amigageek/susy/sim/test_attenuator.asc

M1: pmos; AO6407
R1: res; 4.7K
R2: res; 100K
R3: res; 100K
V1: voltage; 3.3
V2: voltage; SINE(2.2 50m 2k)
V3: voltage; PULSE(0 3.3 0 10m 10m 0m 20m)
V4: voltage; 0
V6: voltage; 2.2
X1: attenuator
Named nets: 0, VCC, SIGNAL, GAIN, VGND, GATE
.global VCC VGND
.MODEL 2SK3557 NJF(BETA=0.026 VTO=-1.04 LAMBDA=0.038 RD=5.6 RS=6.5 IS=0.558f CGS=7.62p CGD=7.62p M=0.33 PB=0.6 FC=0.5 N=1.016 )
.tran 100m
