amigageek/susy/sim/test_ring_modulator.asc

R1: res; 100K
V1: voltage; 3.3
V2: voltage; 2.2
V3: voltage; PULSE(2.15 2.25 0 20m 20m 0 40m)
V4: voltage; SINE(2.2 50m 2000)
X1: ring_modulator
Named nets: 0, VCC, VGND, SIGNAL2, SIGNAL1
.tran 100m
.global VCC VGND
