amigageek/susy/sim/test_calibrate_jfet.asc

J1: njf; 2SK3557
R1: res; 1Meg
R2: res; 1Meg
R3: res; 1K
V1: voltage; 2.2
V2: voltage; 1.54
V3: voltage; 3.3
V4: voltage; 2.25
X1: opamp
X2: opamp
Named nets: VGND, CNTL, 0, VCC, REF
.tran 1
100 ohms at 1.54V
1K ohms at 1.3V
R4=10K for 1K JFET measurement
R4=1K for 100 JFET reasurement
.MODEL 2SK3557 NJF(BETA=0.026 VTO=-1.04 LAMBDA=0.038 RD=5.6 RS=6.5 IS=0.558f CGS=7.62p CGD=7.62p M=0.33 PB=0.6 FC=0.5 N=1.016 )
