amigageek/susy/sim/test_filter.asc

R1: res; 100K
R2: res; 100K
R3: res; 100K
V1: voltage; 3.3
V2: voltage; PULSE(2.15 2.25 0 1u 500u 0 500u); AC 1
V3: voltage; 1
V4: voltage; 3.3
V5: voltage; 1.65
V6: voltage; 2.2
X1: filter
Named nets: 0, VCC, SIGNAL, CUTOFF, RESON, VCC/2, VGND
.ac dec 100 10 10K
.global VCC VCC/2 VGND
.MODEL 2SK3557 NJF(BETA=0.026 VTO=-1.04 LAMBDA=0.038 RD=5.6 RS=6.5 IS=0.558f CGS=7.62p CGD=7.62p M=0.33 PB=0.6 FC=0.5 N=1.016 )
