amigageek/susy/sim/test_line_driver.asc

R1: res; 10K
V1: voltage; 3.3
V2: voltage; 3.3
V7: voltage; PULSE(2.05 2.35 0 1.5m 1.5m 0u 3m)
X1: line_driver
Named nets: 0, VCC, SIGNAL, ON
.tran 100m
.global VCC
