amigageek/susy/sim/test_noise.asc

R1: res; 100K
V1: voltage; 3.3
V2: voltage; 1.65
X1: noise
Named nets: 0, VCC, VCC/2
.tran 10m
.global VCC VCC/2
