amigageek/susy/sim/test_oscillator.asc

R1: res; 100K
R2: res; 100K
R3: res; 100K
R4: res; 100K
V1: voltage; 3.3
V2: voltage; 1.65
V3: voltage; 1.65
V4: voltage; 3.3
V5: voltage; 1.65
V6: voltage; 0
V7: voltage; PULSE(0 3.3 0 1u 1u 150u 300u)
X1: oscillator
Named nets: 0, VCC, VCC/2, VCC/2_COMP, FREQ, DUTY, SYNC_DIS, SYNC_IN
.tran 10m
.global VCC VCC/2 VCC/2_COMP
