amigageek/susy/sim/test_shift_scale.asc

R1: res; 100K
V1: voltage; 3.3
V2: voltage; PULSE(0 3.3 0 250u 250u 0 500u)
X1: shift_scale
Named nets: 0, VCC, SIGNAL
.tran 2m
.global VCC
