amigageek/susy/sim/test_switch2_0.1v.asc

R1: res; 100K
V1: voltage; 3.3
V2: voltage; PULSE(2.15 2.25 0 250u 250u 0 500u)
V3: voltage; 3.3
V5: voltage; PULSE(2.15 2.25 0 1u 1u 250u 500u)
X1: switch2_0.1v
Named nets: 0, VCC, SIGNAL1, SIGNAL2, SELECT
.tran 2m
.global VCC
