amigageek/susy/sim/test_switch4_3.3v.asc

R1: res; 100K
V1: voltage; 3.3
V2: voltage; PULSE(0 3.3 0 250u 250u 0 500u)
V3: voltage; 0
V4: voltage; 0
V5: voltage; PULSE(0 3.3 0 1u 1u 250u 500u)
V6: voltage; PULSE(0 3.3 0 500u 1u 0 500u)
V7: voltage; PULSE(0 3.3 0 1u 500u 0u 500u)
X1: switch4_3.3v
Named nets: 0, VCC, SIGNAL1, SIGNAL2, SIGNAL3, SIGNAL4, SELECT1, SELECT2
.tran 2m
.global VCC
