amigageek/susy/sim/test_toplevel.asc

R1: res; 10K
R2: res; 10K
V1: voltage; 3.3
V3: voltage; 2.2
V4: voltage; 1.65
X1: oscillator
X2: oscillator
X3: oscillator
X4: oscillator
X5: noise
X6: switch4_3.3v
X7: switch4_3.3v
X8: switch4_3.3v
X9: switch4_3.3v
X10: shift_scale
X11: shift_scale
X12: shift_scale
X13: shift_scale
X14: ring_modulator
X15: ring_modulator
X16: switch2_0.1v
X17: switch2_0.1v
X18: filter
X19: filter
X20: filter
X21: filter
X22: switch4_0.1v
X23: switch4_0.1v
X24: switch4_0.1v
X25: switch4_0.1v
X26: attenuator
X27: attenuator
X28: attenuator
X29: attenuator
X30: attenuator
X31: attenuator
X32: attenuator
X33: attenuator
X34: mixer
X35: mixer
X36: line_driver
X37: line_driver
Named nets: 0, VCC, VGND, VCC/2
For reference only, simulation not wired up
