amigageek/susy/sim/attenuator.asc

J1: njf; 2SK3557
J2: njf; 2SK3557
R1: res; 421K
R2: res; 100K
R3: res; 85.6K
R4: res; 100K
R5: res; 1K
R6: res; 1K
R7: res; 1K
R8: res; 1K
R9: res; 100K
X1: opamp
X2: opamp
Named nets: OUT, SIGNAL, 0, GAIN, VGND, VCC
Calibrate J1 gate voltage VG for 50mVpp output @100mVpp input
Shift/scale/invert [0, VCC] to [VGND, VG]:
For SPICE simulation VG = 1.416V
scale = (VGND - VG) / VCC = 0.238 (SPICE)
R1/R2 = 1 / scale
R3/R4 = (scale + 1) * (VCC/VGND) - 1
