amigageek/susy/sim/oscillator.asc

C1: cap; 1n
C2: cap; 1n
M1: nmos; 2N7002
Q1: npn; 2N3904
Q2: npn; 2N3904
Q3: npn; 2N3904
R1: res; 56K
R2: res; 56K
R3: res; 56K
R4: res; 100K
R5: res; 100K
R6: res; 2.2K
R7: res; 100K
R8: res; 4.7K
R9: res; 100K
R10: res; 100K
R11: res; 10K
R12: res; 4.7K
R13: res; 100K
R14: res; 100K
R15: res; 100K
R16: res; 100K
R17: res; 100K
R18: res; 10K
R19: res; 100K
R20: res; 100K
R21: res; 4.7K
R22: res; 1Meg
X1: opamp
X2: opamp
X3: opamp
X4: opamp
X5: opamp
X6: opamp
Named nets: VCC/2, FREQ, DUTY, 0, TRI, PULSE, VCC, SAW, VCC/2_COMP, SYNC_OUT, SYNC_DIS, SYNC_IN
F = FREQ / (8 * 56K * 1n * 3.3)
