amigageek/susy/sim/ring_modulator.asc

D1: schottky; BAT54
D2: schottky; BAT54
D3: schottky; BAT54
D4: schottky; BAT54
R1: res; {r/2}
R2: res; {r}
R3: res; {r/2}
R4: res; {r/4}
R5: res; {r}
R6: res; {r}
R7: res; {r}
R8: res; {r}
R9: res; {r}
R10: res; {r}
R11: res; {r}
X1: opamp
X2: opamp
X3: opamp
X4: opamp
Named nets: VGND, SIGNAL1, SIGNAL2, OUT
.param r 3K
X1 out: -(SIGNAL2 + SIGNAL1)
X2 out: -(SIGNAL2 - SIGNAL1)
D2 + X3: when -(SIGNAL2 + SIGNAL1) < 0, X3 out: (SIGNAL2 + SIGNAL1)^2
D1 + X3: when -(SIGNAL2 - SIGNAL1) > 0, X3 out: -(SIGNAL2 - SIGNAL1)^2
D3 + X4: when -(SIGNAL2 + SIGNAL1) > 0, X4 out: -(SIGNAL2 + SIGNAL1)^2 - U3 out
D4 + X4: when -(SIGNAL2 - SIGNAL1) < 0, X4 out: (SIGNAL2 - SIGNAL1)^2 - U3 out
