amigageek/susy/sim/filter.asc

C1: cap; 0.5µ
C2: cap; 0.5µ
R1: res; 100K
R2: res; 100K
R3: res; 100K
R4: res; 1K
R5: res; 390
X1: jfet_1k_100
X2: jfet_1k_100
X3: jfet_1k_100
X4: opamp
X5: opamp
X6: opamp
Named nets: SIGNAL, VGND, HIGH, BAND, LOW, RESON, CUTOFF
Gain(low) = -R2/R1
Gain(high) = -R3/R1
If R2=R3 R(X2)=R(X3) C1=C2:
Fcenter = 1/(2*PI*R(X2)*C1)
Q = (R4+R5)/(R(X1)*2)
Qmin = 0.707
Qmax = 7
R(X1) = 1K
R(X1) = 100
