amigageek/susy/sim/jfet_1k_100.asc

J1: njf; 2SK3557
R1: res; 118.6K
R2: res; 100K
R3: res; 142.1K
R4: res; 10K
R5: res; 1Meg
R6: res; 1Meg
X1: opamp
X2: opamp
Named nets: CONTROL, SOURCE, DRAIN, VCC, VCC/2
Calibrate R5 input voltage VR5 for 100 and 1K ohms @100mVpp input
For SPICE simulation:
shift = (VR5(max) + VR5(min) - VCC) / 2 = -1.391 (SPICE)
Shift/scale/invert [0, VCC] to [VR5(max), VR5(min)]:
scale = (VR5(max) - VR5(min)) / VCC = 0.121 (SPICE)
R1/R2 = -VCC / (shift * 2)
R3/R4 = ((VCC/2 - shift) / (VCC/2 * scale)) - 1
VR5(max) = 459mV (100 ohm)
VR5(min) = 59mV (1K ohm)
