amigageek/susy/sim/line_driver.asc

C1: polcap; 1µ
D1: diode; 1N4148
D2: diode; 1N4148
M1: nmos; 2N7002
R1: res; 100K
R2: res; 1K
Named nets: 0, OUT, SIGNAL, ON
