amigageek/susy/sim/mixer.asc

R1: res; 100K
R2: res; 100K
R3: res; 100K
R4: res; 100K
R5: res; 300K
X1: opamp
Named nets: SIGNAL1, SIGNAL2, SIGNAL3, SIGNAL4, VGND, OUT
