amigageek/susy/sim/noise.asc

C1: cap; 100n
D1: zener; 1N750
Q1: npn; 2N3904
R1: res; 82K
R2: res; 1K
R3: res; 100K
R4: res; 100K
R5: res; 100K
R6: res; 2.2K
R7: res; 100K
X1: opamp
X2: opamp
Named nets: VCC, 0, VCC/2, OUT
No diode model with noise, test is non-functional
Parameters from prototype with LM385BLPE3-1-2
