amigageek/susy/sim/opamp.asc

U1: UniversalOpamp2; Avol=1Meg GBW=1.2Meg Slew=10Meg
Named nets: 0, VCC, OUT, IN+, IN-
