amigageek/susy/sim/shift_scale.asc

R1: res; 330K
R2: res; 10K
R3: res; 82K
R4: res; 10K
R5: res; 180K
X1: opamp
Named nets: VCC, SIGNAL, 0, OUT
Shift/scale [0.0V, 3.3V] to [2.15V, 2.25V]
shift = 2.2 - 1.65 = 0.55
scale = 0.1 / 3.3 = 1/33
R2 / R1 = scale
(R3 + R4) / R5 =
  1 - ((2 * shift) / ((1.65 * (1 + scale)) + shift))
