amigageek/susy/sim/switch2_0.1v.asc

C1: cap; 10n
M1: nmos; AO6408
M2: pmos; AO6407
R1: res; 4.7K
R9: res; 470
R10: res; 470
X1: opamp
Named nets: SIGNAL1, SIGNAL2, SELECT, OUT, 0
