amigageek/susy/sim/switch4_0.1v.asc

C1: cap; 10n
M1: nmos; AO6408
M2: pmos; AO6407
M3: nmos; AO6408
M4: pmos; AO6407
M5: nmos; AO6408
M6: pmos; AO6407
R1: res; 4.7K
R2: res; 4.7K
R3: res; 4.7K
R6: res; 470
R9: res; 470
R10: res; 470
R11: res; 370
X1: opamp
Named nets: SIGNAL1, SIGNAL2, SELECT1, SELECT2, OUT, 0, SIGNAL3, SIGNAL4
