amigageek/susy/sim/switch4_3.3v.asc

C1: cap; 1p
R1: res; 470
R2: res; 470
R3: res; 470
R4: res; 470
X1: switch_off_3.3v
X2: switch_on_3.3v
X3: switch_off_3.3v
X4: switch_on_3.3v
X5: switch_off_3.3v
X6: switch_on_3.3v
Named nets: SIGNAL1, SIGNAL2, SIGNAL3, SIGNAL4, SELECT1, SELECT2, OUT, 0
