amigageek/susy/sim/switch_off_3.3v.asc

Q1: npn; 2N3904
Q2: npn; 2N3904
Q3: pnp; 2N3906
R1: res; 100K
R2: res; 100K
R3: res; 100K
R4: res; 100K
Named nets: VCC, 0, SIGNAL, CONTROL, OUT
