amigageek/susy/sim/switch_on_3.3v.asc

Q1: pnp; 2N3906
Q2: pnp; 2N3906
Q3: npn; 2N3904
R1: res; 100K
R2: res; 100K
R3: res; 100K
R4: res; 100K
Named nets: CONTROL, SIGNAL, VCC, 0, OUT
