amigageek/susy/pcb/interface/interface.kicad_pcb

## KiCad design pcb/interface/interface.kicad_pcb (2022-05-02)

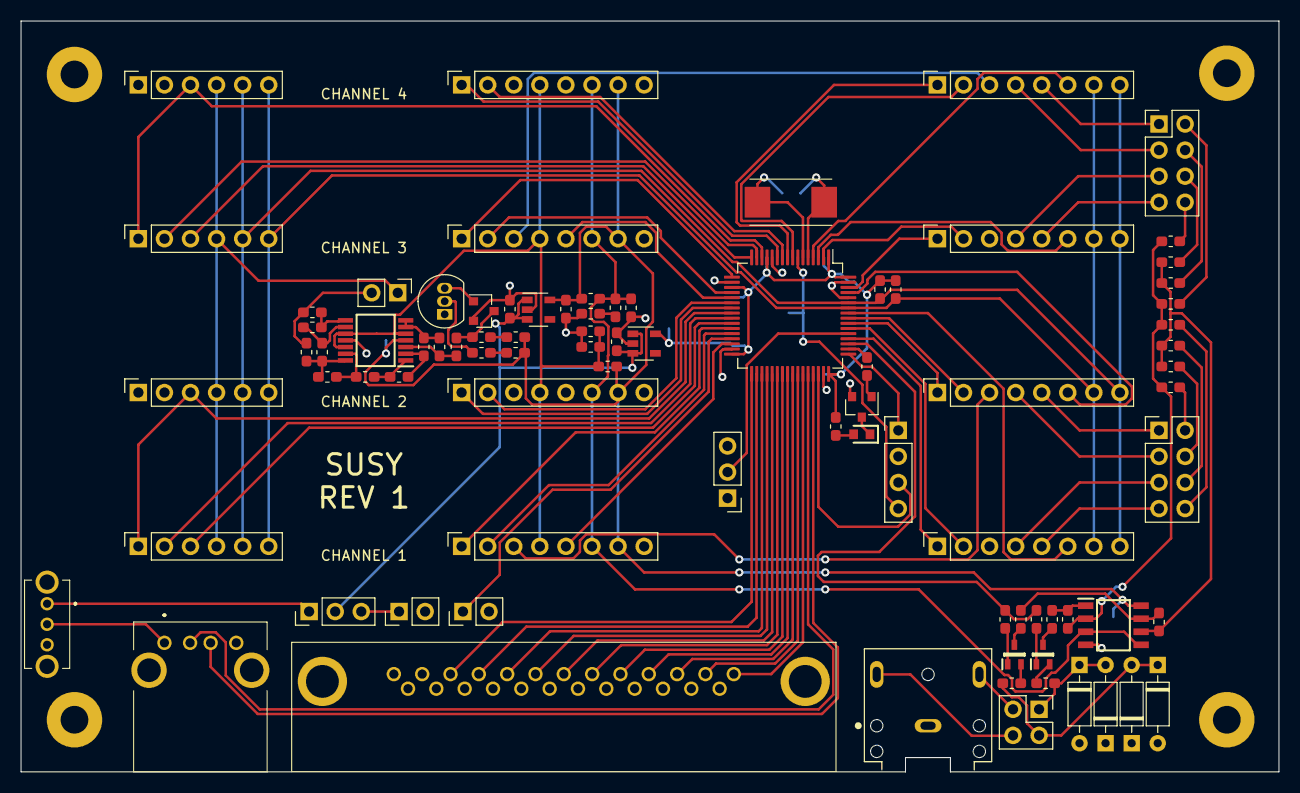
[picture p1: board interface.kicad_pcb from above]

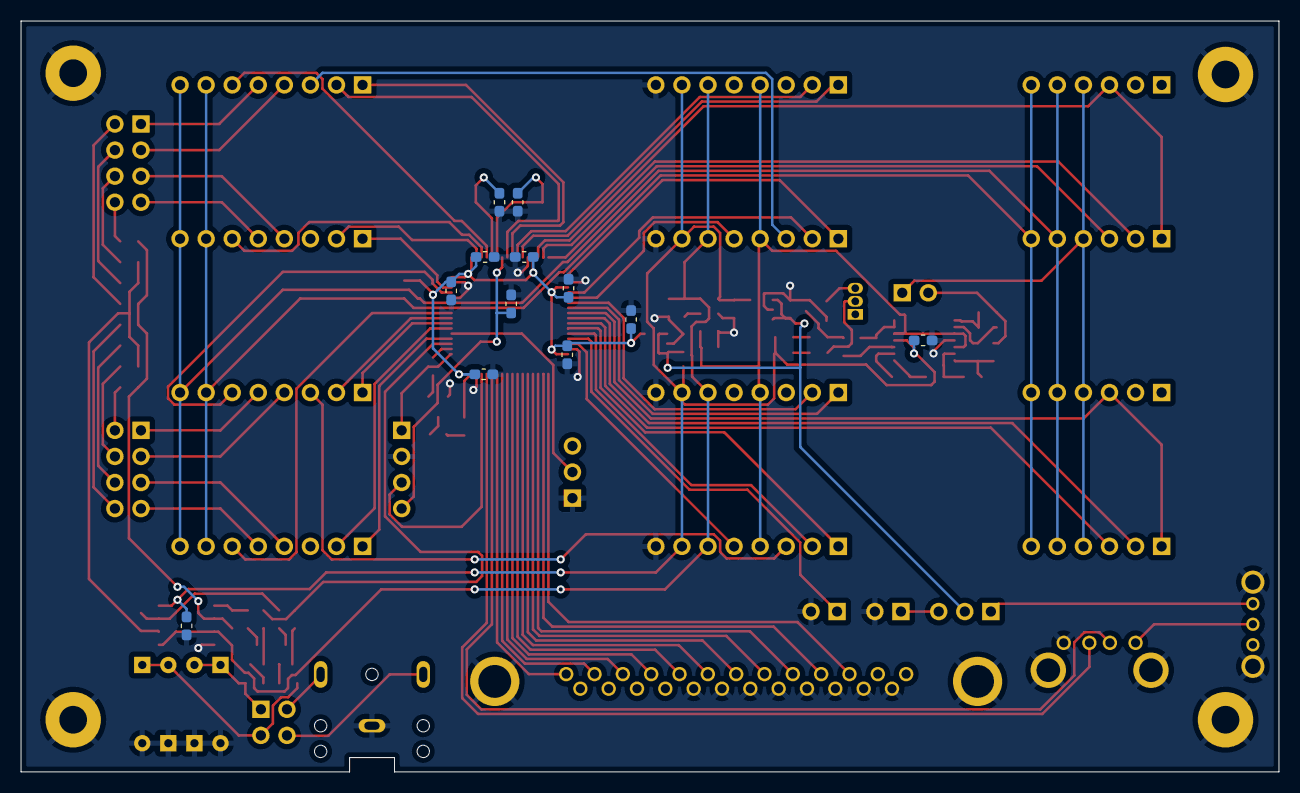
[picture p2: board interface.kicad_pcb from below]

Board: 2 copper layers, 122.6 x 73.2 mm, 101 parts (12 on the bottom side), 112 nets.

Parts:
C1, C2, C3, C4, C5, C6, C16, C19, C20: 100nF; C_0603_1608Metric_Pad1.05x0.95mm_HandSolder
C7: 10nF; C_0603_1608Metric_Pad1.05x0.95mm_HandSolder
C8, C10, C14, C15, C17, C18: 1uF; C_0603_1608Metric_Pad1.05x0.95mm_HandSolder
C9, C11: 4.7uF; C_0603_1608Metric_Pad1.05x0.95mm_HandSolder
C12, C13: 8pF; C_0603_1608Metric_Pad1.05x0.95mm_HandSolder
D1, D2, D3, D4: 1N4148; D_DO-35_SOD27_P7.62mm_Horizontal
H1, H2, H3, H4: MountingHole_Pad; MountingHole_2.7mm_M2.5_Pad
IC1: MCP6072-E_SN; SOIC127P600X175-8N
IC2: MCP6074-E_ST; SOP65P640X120-14N
J1, J2, J3, J4: Conn_01x06_Female; PinSocket_1x06_P2.54mm_Vertical
J5, J6, J7, J8, J9, J10, J11, J12: Conn_01x08_Female; PinSocket_1x08_P2.54mm_Vertical
J13: Conn_01x04_Male; PinHeader_1x04_P2.54mm_Vertical
J14: Parallel/USB; PinHeader_1x03_P2.54mm_Vertical
J15: D25S33E4PA00LF
J16: UJ2-AH-4-TH; UJ2AH4TH
J17: Spare; PinHeader_1x02_P2.54mm_Vertical
J18: Pwr Sel; PinHeader_1x03_P2.54mm_Vertical
J19: Pwr Ext; PinHeader_1x02_P2.54mm_Vertical
J20: SJ1-3523N; CUI_SJ1-3523N
J21: Conn_01x02_Male; PinHeader_1x02_P2.54mm_Vertical
J22: Conn_02x02_Top_Bottom; PinHeader_2x02_P2.54mm_Vertical
J23, J24: Conn_02x04_Top_Bottom; PinHeader_2x04_P2.54mm_Vertical
LED1: SML-D12U1WT86; LEDC1608X65N
Q1, Q4: MMBT3904; SOT-23
Q2, Q3: NX3008NBKW,115; SOT65P210X110-3N
R1, R2: 10k; R_0603_1608Metric_Pad1.05x0.95mm_HandSolder
R3: 47; R_0603_1608Metric_Pad1.05x0.95mm_HandSolder
R4: 33K; R_0603_1608Metric_Pad1.05x0.95mm_HandSolder
R5, R6, R7, R8, R9, R10, R12, R14, R15, R16, R17, R19, R20, R21, R22, R30, R32: 100k; R_0603_1608Metric_Pad1.05x0.95mm_HandSolder
R11, R13: 1k; R_0603_1608Metric_Pad1.05x0.95mm_HandSolder
R18, R23: 300k; R_0603_1608Metric_Pad1.05x0.95mm_HandSolder
R24, R25, R26, R27, R29, R33, R34: 1; R_0603_1608Metric_Pad1.05x0.95mm_HandSolder
R28, R31: 2k; R_0603_1608Metric_Pad1.05x0.95mm_HandSolder
R35, R36: 0; R_0603_1608Metric_Pad1.05x0.95mm_HandSolder
S1: OS102011MA1QN1C
U1: STM32F070RBTx; LQFP-64_10x10mm_P0.5mm
U2, U3: MIC5365-3.3YD5; SOT-23-5
U4: LM385BZ-1.2; TO-92_Inline
Y1: NX8045GB-8.000M-STD-CSJ-1; NX8045GB8000MSTDCSJ1

Connections:
/Line Driver (L)/LINE_OUT: D1.2, D2.1, J22.1, R11.1
/Line Driver (R)/LINE_OUT: D3.2, D4.1, J22.2, R13.1
/Mixer (L)/IN1: J24.8, R14.2
/Mixer (L)/IN2: J24.2, R15.2
/Mixer (L)/IN3: J23.8, R16.2
/Mixer (L)/IN4: J23.2, R17.2
/Mixer (L)/OP-: IC1.2, R14.1, R15.1, R16.1, R17.1, R18.2
/Mixer (R)/IN1: J24.6, R19.2
/Mixer (R)/IN2: J24.4, R20.2
/Mixer (R)/IN3: J23.6, R21.2
/Mixer (R)/IN4: J23.4, R22.2
/Mixer (R)/OP-: IC1.6, R19.1, R20.1, R21.1, R22.1, R23.2
/Noise/OUT: J21.2, R35.1, R36.1
/Regulator (VCC)/VIN: C8.1, C10.1, J18.2, U2.1, U2.3, U3.1, U3.3
FSEL1A: J9.2, U1.54
FSEL1B: J9.1, U1.52
FSEL2A: J10.2, U1.56
FSEL2B: J10.1, U1.55
FSEL3A: J11.2, U1.2
FSEL3B: J11.1, U1.62
FSEL4A: J12.2, U1.8
FSEL4B: J12.1, U1.9
GATE1: J9.6, U1.57
GATE2: J10.6, U1.61
GATE3: J11.6, U1.3
GATE4: J12.6, U1.4
GND: C1.2, C2.1, C3.1, C4.1, C5.1, C6.1, C7.1, C8.2, C9.2, C10.2, C11.2, C12.1, C13.1, C14.2, C15.2, C16.2, C20.2, D1.1, D2.2, D3.1, D4.2, H1.1, H2.1, H3.1, H4.1, IC1.4, IC2.11, J5.8, J6.8, J7.8, J8.8, J13.2, J14.1, J15.2, J15.4, J15.6, J15.8, J15.10, J15.12, J15.14, J15.16, J15.MH1, J15.MH2, J16.4, J16.MH1, J16.MH2, J17.2, J19.2, J20.1, Q1.2, Q4.2, R6.2, R9.2, S1.MH1, S1.MH2, U1.12, U1.18, U1.31, U1.47, U1.60, U1.63, U2.2, U3.2
LEFT: C17.2, IC1.1, R18.1
LEFT1: J9.5, J24.7
LEFT2: J10.5, J24.1
LEFT3: J11.5, J23.7
LEFT4: J12.5, J23.1
LINEL: J20.2, J22.3
LINER: J20.3, J22.4
LINE_EN: R10.1, R12.1, U1.51
NOISE: J1.4, J2.4, J3.4, J4.4, J21.1
unnamed: C1.1, J13.4, U1.7
unnamed: C12.2, U1.6, Y1.2
unnamed: C13.2, U1.5, Y1.1
unnamed: C17.1, Q2.3
unnamed: C18.1, Q3.3
unnamed: C19.1, IC2.3, R29.1
unnamed: C19.2, Q4.3, R27.2
unnamed: IC2.1, R30.1, R31.2
unnamed: IC2.2, R28.2, R30.2
unnamed: IC2.8, R33.2, R36.2
unnamed: IC2.9, R33.1, R34.2
unnamed: IC2.13, R31.1, R32.2
unnamed: IC2.14, R32.1, R34.1, R35.2
unnamed: J5.3, J10.3
unnamed: J7.3, J12.3
unnamed: J13.1, U1.49
unnamed: J13.3, U1.46
unnamed: J14.2, U1.53
unnamed: J16.1, S1.2
unnamed: J17.1, U1.29
unnamed: J18.3, J19.1
unnamed: LED1.1, Q1.3
unnamed: LED1.2, R3.2
unnamed: Q1.1, R4.2
unnamed: Q2.1, R10.2
unnamed: Q2.2, R11.2
unnamed: Q3.1, R12.2
unnamed: Q3.2, R13.2
unnamed: Q4.1, U4.3
unnamed: R4.1, U1.50
unnamed: R8.2, R9.1
unnamed: R24.2, R25.1
unnamed: R25.2, U4.2
unnamed: R26.2, R27.1
OSEL1A: J5.2, U1.28
OSEL1B: J5.1, U1.27
OSEL2A: J6.2, U1.22
OSEL2B: J6.1, U1.23
OSEL3A: J7.2, U1.20
OSEL3B: J7.1, U1.17
OSEL4A: J8.2, U1.10
OSEL4B: J8.1, U1.11
PACK: J15.7, U1.34
PBUSY: J15.5, U1.33
PDATA0: J15.23, U1.42
PDATA1: J15.21, U1.41
PDATA2: J15.19, U1.40
PDATA3: J15.17, U1.39
PDATA4: J15.15, U1.38
PDATA5: J15.13, U1.37
PDATA6: J15.11, U1.36
PDATA7: J15.9, U1.35
PSTROBE: J15.25, U1.43
RIGHT: C18.2, IC1.7, R23.1
RIGHT1: J9.4, J24.5
RIGHT2: J10.4, J24.3
RIGHT3: J11.4, J23.5
RIGHT4: J12.4, J23.3
RMSEL1: J5.5, U1.30
RMSEL2: J7.5, U1.21
SCL: J1.6, J2.6, J3.6, J4.6, J9.7, J10.7, J11.7, J12.7, R1.2, U1.58
SDA: J1.5, J2.5, J3.5, J4.5, J9.8, J10.8, J11.8, J12.8, R2.2, U1.59
SYNC_DIS1: J1.2, U1.25
SYNC_DIS2: J3.2, U1.15
SYNC_OUT1: J1.3, U1.26
SYNC_OUT2: J1.1, J2.3, U1.24
SYNC_OUT3: J3.3, U1.16
SYNC_OUT4: J3.1, J4.3, U1.14
UDATA+: J16.3, U1.45
UDATA-: J16.2, U1.44
VBUS: J18.1, S1.1
VCC: C9.1, C16.1, C20.1, IC1.8, IC2.4, J5.7, J6.7, J7.7, J8.7, R5.1, R7.1, R24.1, R26.1, U2.5
VDD: C2.2, C3.2, C4.2, C5.2, C6.2, C7.2, C11.1, R1.1, R2.1, R3.1, U1.1, U1.13, U1.19, U1.32, U1.48, U1.64, U3.5
VGND_REF: C15.1, IC1.3, IC1.5, J5.6, J6.6, J7.6, J8.6, R7.2, R8.1
VHALF: IC2.6, IC2.7, R28.1, R29.2
VHALF_REF: C14.1, IC2.5, IC2.10, IC2.12, J5.4, J6.4, J7.4, J8.4, R5.2, R6.1
