amigageek/susy/pcb/channel/channel.kicad_pcb

## KiCad design pcb/channel/channel.kicad_pcb (2021-05-17)

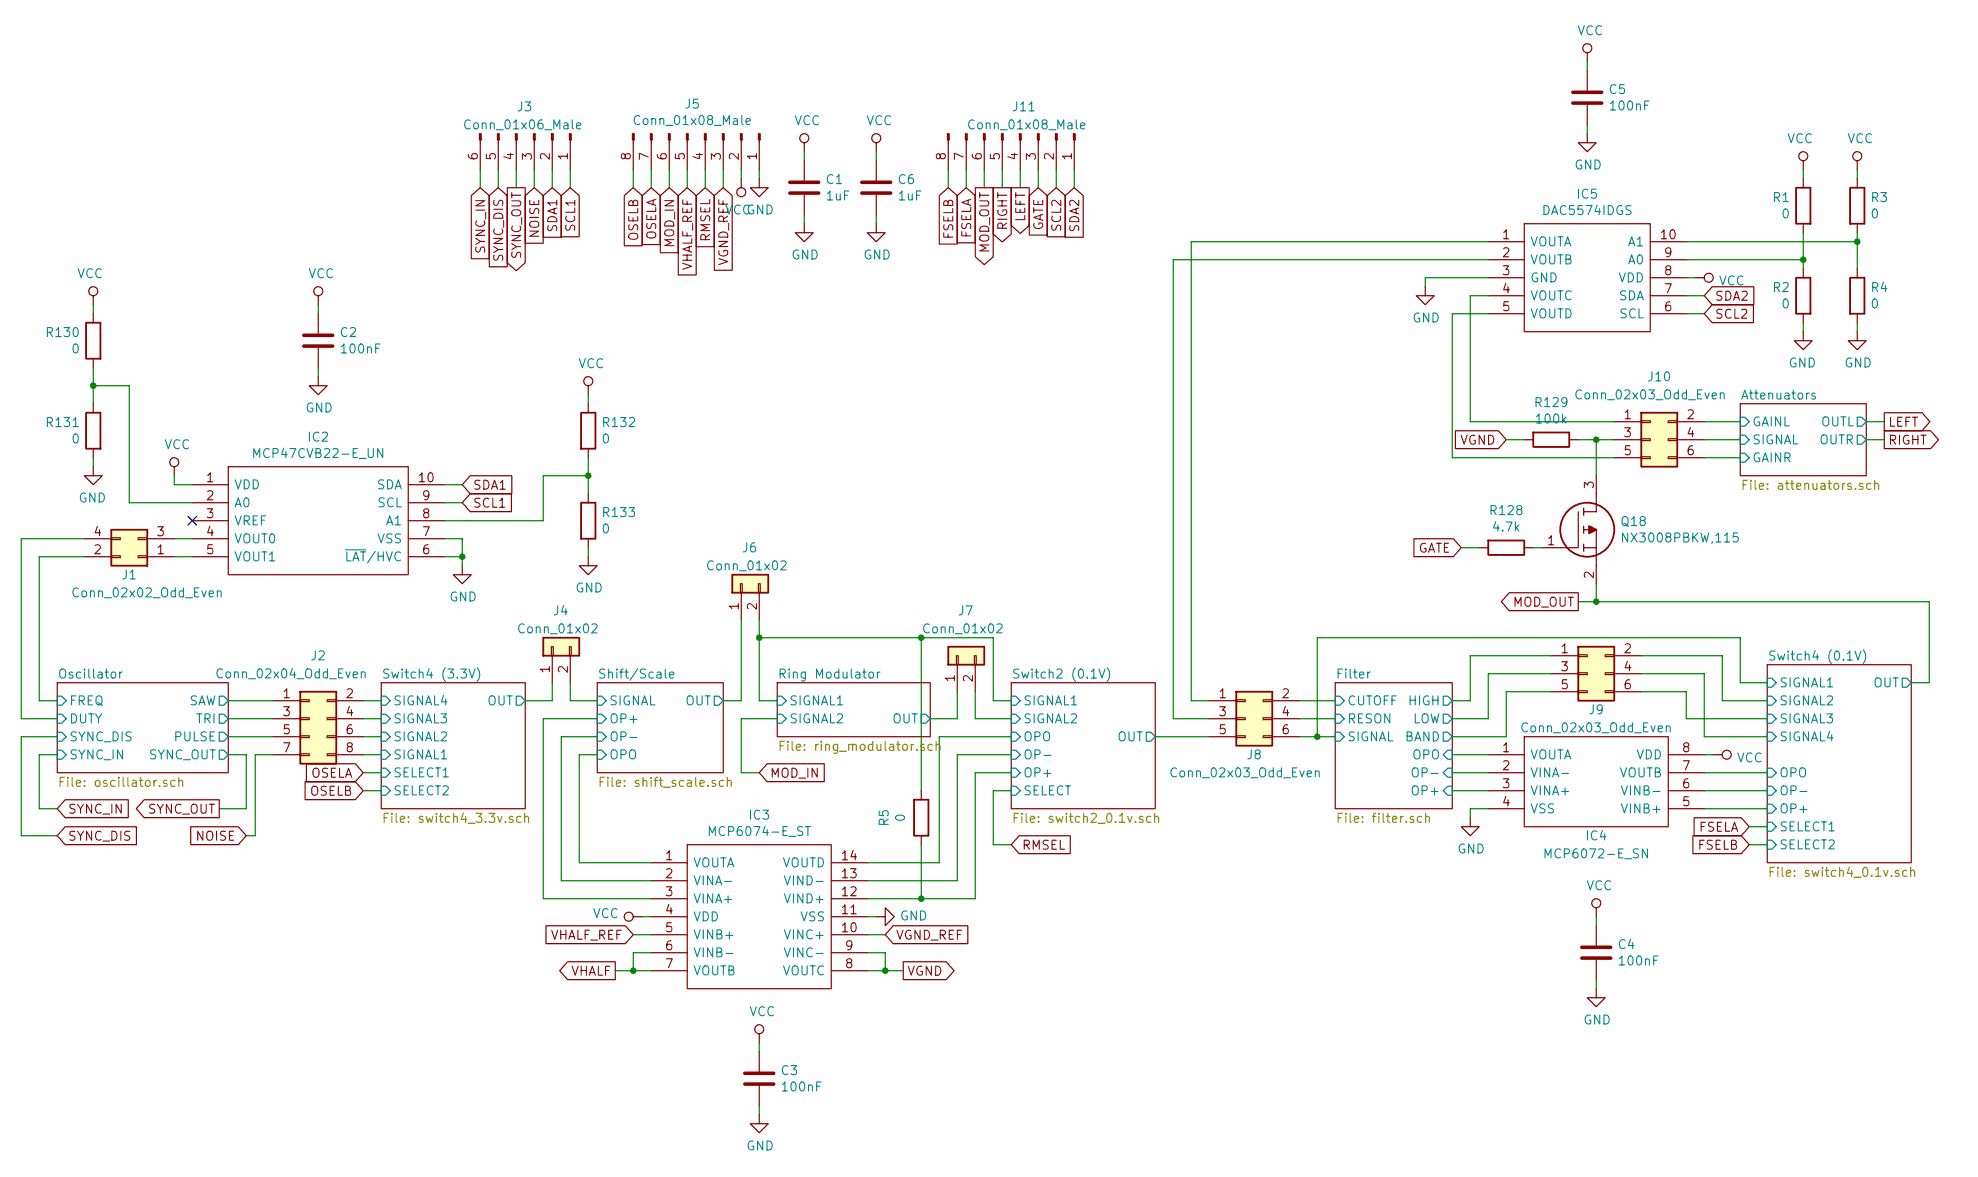
[picture p3: schematic channel.sch]

Parts:
C1, C6: 1uF; C_0603_1608Metric_Pad1.08x0.95mm_HandSolder
C2, C3, C4, C5: 100nF; C_0603_1608Metric_Pad1.08x0.95mm_HandSolder
IC2: MCP47CVB22-E_UN; SOP50P490X110-10N; Manufacturer_Part_Number MCP47CVB22-E/UN; Mouser Part Number 579-MCP47CVB22-E/UN
IC3: MCP6074-E_ST; SOP65P640X120-14N; Manufacturer_Part_Number MCP6074-E/ST; Mouser Part Number 579-MCP6074-E/ST
IC4: MCP6072-E_SN; SOIC127P600X175-8N; Manufacturer_Part_Number MCP6072-E/SN; Mouser Part Number 579-MCP6072-E/SN
IC5: DAC5574IDGS; SOP50P490X110-10N; Manufacturer_Part_Number DAC5574IDGS; Mouser Part Number 595-DAC5574IDGS
J1: Conn_02x02_Odd_Even; PinHeader_2x02_P2.54mm_Vertical
J2: Conn_02x04_Odd_Even; PinHeader_2x04_P2.54mm_Vertical
J3: Conn_01x06_Male; PinHeader_1x06_P2.54mm_Horizontal
J4, J6, J7: Conn_01x02; PinHeader_1x02_P2.54mm_Vertical
J5, J11: Conn_01x08_Male; PinHeader_1x08_P2.54mm_Horizontal
J8, J9, J10: Conn_02x03_Odd_Even; PinHeader_2x03_P2.54mm_Vertical
Q18: NX3008PBKW,115; SOT65P210X110-3N; Manufacturer_Part_Number NX3008PBKW,115; Mouser Part Number 771-NX3008PBKW,115
R1, R2, R3, R4, R5, R130, R131, R132, R133: 0; R_0603_1608Metric_Pad1.05x0.95mm_HandSolder
R128: 4.7k; R_0603_1608Metric_Pad1.05x0.95mm_HandSolder
R129: 100k; R_0603_1608Metric_Pad1.05x0.95mm_HandSolder

Connections:
/Attenuators/GAINL: J10.2; also elsewhere on the board
/Attenuators/GAINR: J10.6; also elsewhere on the board
/Attenuators/SIGNAL: J10.4; also elsewhere on the board
/Filter/BAND: J9.5; also elsewhere on the board
/Filter/CUTOFF: J8.2; also elsewhere on the board
/Filter/HIGH: J9.1; also elsewhere on the board
/Filter/LOW: J9.3; also elsewhere on the board
/Filter/OP+: IC4.3 (VINA+); also elsewhere on the board
/Filter/OP-: IC4.2 (VINA-); also elsewhere on the board
/Filter/OPO: IC4.1 (VOUTA); also elsewhere on the board
/Filter/RESON: J8.4; also elsewhere on the board
/Filter/SIGNAL: J8.6; also elsewhere on the board
/Oscillator/DUTY: J1.4; also elsewhere on the board
/Oscillator/FREQ: J1.2; also elsewhere on the board
/Oscillator/PULSE: J2.5; also elsewhere on the board
/Oscillator/SAW: J2.1; also elsewhere on the board
/Oscillator/TRI: J2.3; also elsewhere on the board
/Ring Modulator/OUT: J7.1; also elsewhere on the board
/Ring Modulator/SIGNAL1: J6.2, R5.2; also elsewhere on the board
/Shift/Scale/OP+: IC3.3 (VINA+); also elsewhere on the board
/Shift/Scale/OP-: IC3.2 (VINA-); also elsewhere on the board
/Shift/Scale/OPO: IC3.1 (VOUTA), J6.1; also elsewhere on the board
/Shift/Scale/SIGNAL: J4.2; also elsewhere on the board
/Switch2 (0.1V)/OP+: IC3.12 (VIND+), R5.1; also elsewhere on the board
/Switch2 (0.1V)/OP-: IC3.13 (VIND-), IC3.14 (VOUTD), J8.5
/Switch2 (0.1V)/SIGNAL2: J7.2; also elsewhere on the board
/Switch4 (0.1V)/OP+: IC4.5 (VINB+); also elsewhere on the board
/Switch4 (0.1V)/SIGNAL2: J9.2; also elsewhere on the board
/Switch4 (0.1V)/SIGNAL3: J9.6; also elsewhere on the board
/Switch4 (0.1V)/SIGNAL4: J9.4; also elsewhere on the board
/Switch4 (3.3V)/OUT: J4.1; also elsewhere on the board
/Switch4 (3.3V)/SIGNAL1: J2.8; also elsewhere on the board
/Switch4 (3.3V)/SIGNAL2: J2.6; also elsewhere on the board
/Switch4 (3.3V)/SIGNAL3: J2.4; also elsewhere on the board
/Switch4 (3.3V)/SIGNAL4: J2.2; also elsewhere on the board
FSELA: J11.7; also elsewhere on the board
FSELB: J11.8; also elsewhere on the board
GATE: J11.3, R128.2
GND: C1.2, C2.2, C3.2, C4.2, C5.2, C6.2, IC2.6 (~LAT~/HVC), IC2.7 (VSS), IC3.11 (VSS), IC4.4 (VSS), IC5.3 (GND), J5.1, R2.2, R4.2, R131.2, R133.2; also elsewhere on the board
LEFT: J11.4; also elsewhere on the board
MOD_IN: J5.6; also elsewhere on the board
MOD_OUT: IC4.6 (VINB-), IC4.7 (VOUTB), J11.6, Q18.2
NOISE: J2.7, J3.3
unnamed: IC2.2 (A0), R130.2, R131.1
unnamed: IC2.4 (VOUT0), J1.3
unnamed: IC2.5 (VOUT1), J1.1
unnamed: IC2.8 (A1), R132.2, R133.1
unnamed: IC5.1 (VOUTA), J8.1
unnamed: IC5.2 (VOUTB), J8.3
unnamed: IC5.4 (VOUTC), J10.1
unnamed: IC5.5 (VOUTD), J10.5
unnamed: IC5.9 (A0), R1.2, R2.1
unnamed: IC5.10 (A1), R3.2, R4.1
unnamed: J10.3, Q18.3, R129.1
unnamed: Q18.1, R128.1
OSELA: J5.7; also elsewhere on the board
OSELB: J5.8; also elsewhere on the board
RIGHT: J11.5; also elsewhere on the board
RMSEL: J5.4; also elsewhere on the board
SCL1: IC2.9 (SCL), J3.1
SCL2: IC5.6 (SCL), J11.2
SDA1: IC2.10 (SDA), J3.2
SDA2: IC5.7 (SDA), J11.1
SYNC_DIS: J3.5; also elsewhere on the board
SYNC_IN: J3.6; also elsewhere on the board
SYNC_OUT: J3.4; also elsewhere on the board
VCC: C1.1, C2.1, C3.1, C4.1, C5.1, C6.1, IC2.1 (VDD), IC3.4 (VDD), IC4.8 (VDD), IC5.8 (VDD), J5.2, R1.1, R3.1, R130.1, R132.1; also elsewhere on the board
VGND: IC3.8 (VOUTC), IC3.9 (VINC-), R129.2; also elsewhere on the board
VGND_REF: IC3.10 (VINC+), J5.3
VHALF: IC3.6 (VINB-), IC3.7 (VOUTB); also elsewhere on the board
VHALF_REF: IC3.5 (VINB+), J5.5

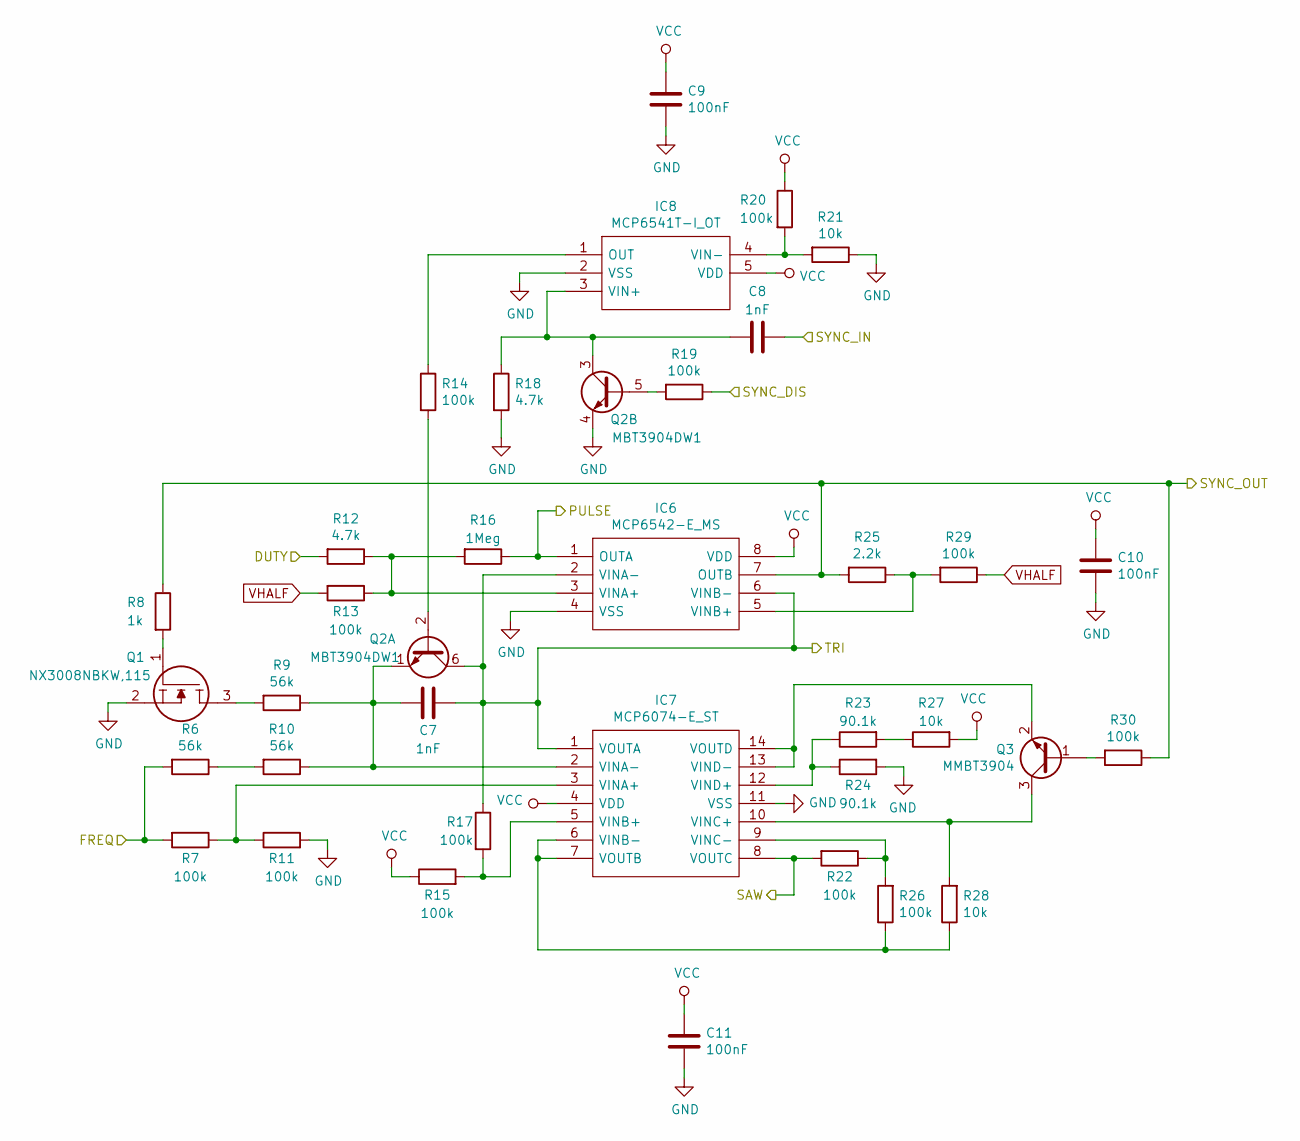
[picture p4: schematic oscillator.sch]

Parts:
C7, C8: 1nF; C_0603_1608Metric_Pad1.08x0.95mm_HandSolder
C9, C10, C11: 100nF; C_0603_1608Metric_Pad1.08x0.95mm_HandSolder
IC6: MCP6542-E_MS; SOP65P490X110-8N; Manufacturer_Part_Number MCP6542-E/MS; Mouser Part Number 579-MCP6542-E/MS
IC7: MCP6074-E_ST; SOP65P640X120-14N; Manufacturer_Part_Number MCP6074-E/ST; Mouser Part Number 579-MCP6074-E/ST
IC8: MCP6541T-I_OT; SOT95P270X145-5N; Manufacturer_Part_Number MCP6541T-I/OT; Mouser Part Number 579-MCP6541T-I/OT
Q1: NX3008NBKW,115; SOT65P210X110-3N; Manufacturer_Part_Number NX3008NBKW,115; Mouser Part Number 771-NX3008NBKW,115
Q2: MBT3904DW1; SOT-363_SC-70-6
Q3: MMBT3904; SOT-23
R6, R9, R10: 56k; R_0603_1608Metric_Pad1.05x0.95mm_HandSolder
R7, R11, R13, R14, R15, R17, R19, R20, R22, R26, R29, R30: 100k; R_0603_1608Metric_Pad1.05x0.95mm_HandSolder
R8: 1k; R_0603_1608Metric_Pad1.05x0.95mm_HandSolder
R12, R18: 4.7k; R_0603_1608Metric_Pad1.05x0.95mm_HandSolder
R16: 1Meg; R_0603_1608Metric_Pad1.05x0.95mm_HandSolder
R21, R27, R28: 10k; R_0603_1608Metric_Pad1.05x0.95mm_HandSolder
R23, R24: 90.1k; R_0603_1608Metric_Pad1.05x0.95mm_HandSolder
R25: 2.2k; R_0603_1608Metric_Pad1.05x0.95mm_HandSolder

Connections:
/Oscillator/DUTY: R12.2; also elsewhere on the board
/Oscillator/FREQ: R6.2, R7.2; also elsewhere on the board
/Oscillator/PULSE: IC6.1 (OUTA), R16.1; also elsewhere on the board
/Oscillator/SAW: IC7.8 (VOUTC), R22.2; also elsewhere on the board
/Oscillator/TRI: C7.1, IC6.2 (VINA-), IC6.6 (VINB-), IC7.1 (VOUTA), Q2.6 (C1), R17.1; also elsewhere on the board
GND: C9.2, C10.2, C11.2, IC6.4 (VSS), IC7.11 (VSS), IC8.2 (VSS), Q1.2, Q2.4 (E2), R11.2, R18.2, R21.1, R24.2; also elsewhere on the board
unnamed: C7.2, IC7.2 (VINA-), Q2.1 (E1), R9.1, R10.1
unnamed: C8.2, IC8.3 (VIN+), Q2.3 (C2), R18.1
unnamed: IC6.3 (VINA+), R12.1, R13.1, R16.2
unnamed: IC6.5 (VINB+), R25.1, R29.2
unnamed: IC7.3 (VINA+), R7.1, R11.1
unnamed: IC7.5 (VINB+), R15.2, R17.2
unnamed: IC7.6 (VINB-), IC7.7 (VOUTB), R26.1, R28.1
unnamed: IC7.9 (VINC-), R22.1, R26.2
unnamed: IC7.10 (VINC+), Q3.3 (C), R28.2
unnamed: IC7.12 (VIND+), R23.1, R24.1
unnamed: IC7.13 (VIND-), IC7.14 (VOUTD), Q3.2 (E)
unnamed: IC8.1 (OUT), R14.1
unnamed: IC8.4 (VIN-), R20.2, R21.2
unnamed: Q1.1, R8.2
unnamed: Q1.3, R9.2
unnamed: Q2.2 (B1), R14.2
unnamed: Q2.5 (B2), R19.2
unnamed: Q3.1 (B), R30.2
unnamed: R6.1, R10.2
unnamed: R23.2, R27.1
SYNC_DIS: R19.1; also elsewhere on the board
SYNC_IN: C8.1; also elsewhere on the board
SYNC_OUT: IC6.7 (OUTB), R8.1, R25.2, R30.1; also elsewhere on the board
VCC: C9.1, C10.1, C11.1, IC6.8 (VDD), IC7.4 (VDD), IC8.5 (VDD), R15.1, R20.1, R27.2; also elsewhere on the board
VHALF: R13.2, R29.1; also elsewhere on the board

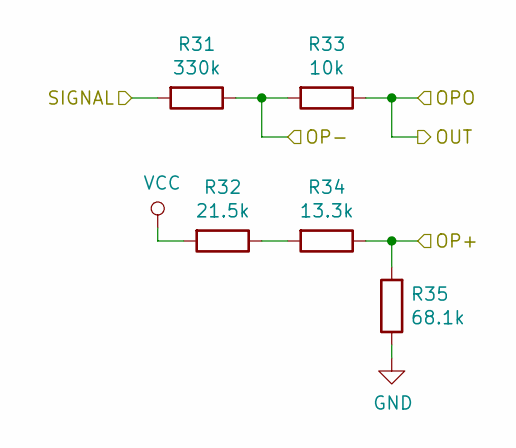
[picture p5: schematic shift_scale.sch]

Parts:
R31: 330k; R_0603_1608Metric_Pad1.05x0.95mm_HandSolder
R32: 21.5k; R_0603_1608Metric_Pad1.05x0.95mm_HandSolder
R33: 10k; R_0603_1608Metric_Pad1.05x0.95mm_HandSolder
R34: 13.3k; R_0603_1608Metric_Pad1.05x0.95mm_HandSolder
R35: 68.1k; R_0603_1608Metric_Pad1.05x0.95mm_HandSolder

Connections:
/Shift/Scale/OP+: R34.1, R35.2; also elsewhere on the board
/Shift/Scale/OP-: R31.1, R33.2; also elsewhere on the board
/Shift/Scale/OPO: R33.1; also elsewhere on the board
/Shift/Scale/SIGNAL: R31.2; also elsewhere on the board
GND: R35.1; also elsewhere on the board
unnamed: R32.1, R34.2
VCC: R32.2; also elsewhere on the board

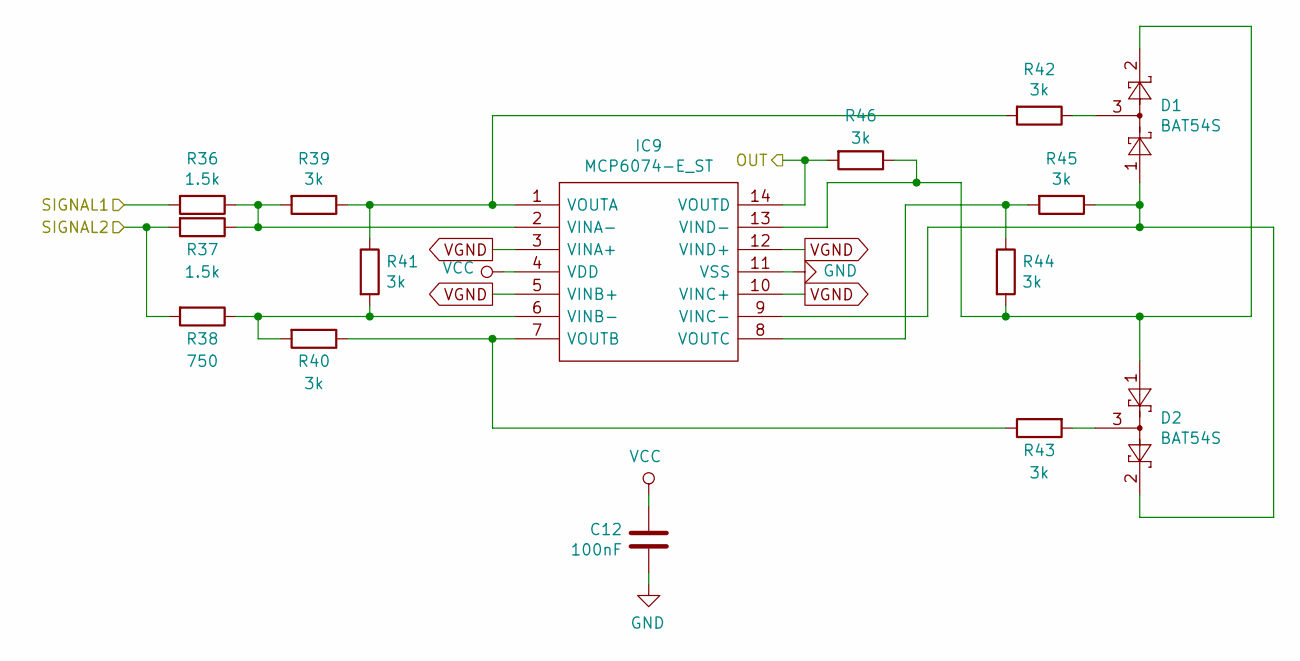
[picture p6: schematic ring_modulator.sch]

Parts:
C12: 100nF; C_0603_1608Metric_Pad1.08x0.95mm_HandSolder
D1, D2: BAT54S; SOT-23
IC9: MCP6074-E_ST; SOP65P640X120-14N; Manufacturer_Part_Number MCP6074-E/ST; Mouser Part Number 579-MCP6074-E/ST
R36, R37: 1.5k; R_0603_1608Metric_Pad1.05x0.95mm_HandSolder
R38: 750; R_0603_1608Metric_Pad1.05x0.95mm_HandSolder
R39, R40, R41, R42, R43, R44, R45, R46: 3k; R_0603_1608Metric_Pad1.05x0.95mm_HandSolder

Connections:
/Ring Modulator/OUT: IC9.14 (VOUTD), R46.2; also elsewhere on the board
/Ring Modulator/SIGNAL1: R36.2; also elsewhere on the board
GND: C12.2, IC9.11 (VSS); also elsewhere on the board
MOD_IN: R37.2, R38.2; also elsewhere on the board
unnamed: D1.1, D2.2, IC9.9 (VINC-), R45.1
unnamed: D1.2, D2.1, IC9.13 (VIND-), R44.2, R46.1
unnamed: D1.3, R42.1
unnamed: D2.3, R43.2
unnamed: IC9.1 (VOUTA), R39.1, R41.1, R42.2
unnamed: IC9.2 (VINA-), R36.1, R37.1, R39.2
unnamed: IC9.6 (VINB-), R38.1, R40.2, R41.2
unnamed: IC9.7 (VOUTB), R40.1, R43.1
unnamed: IC9.8 (VOUTC), R44.1, R45.2
VCC: C12.1, IC9.4 (VDD); also elsewhere on the board
VGND: IC9.3 (VINA+), IC9.5 (VINB+), IC9.10 (VINC+), IC9.12 (VIND+); also elsewhere on the board

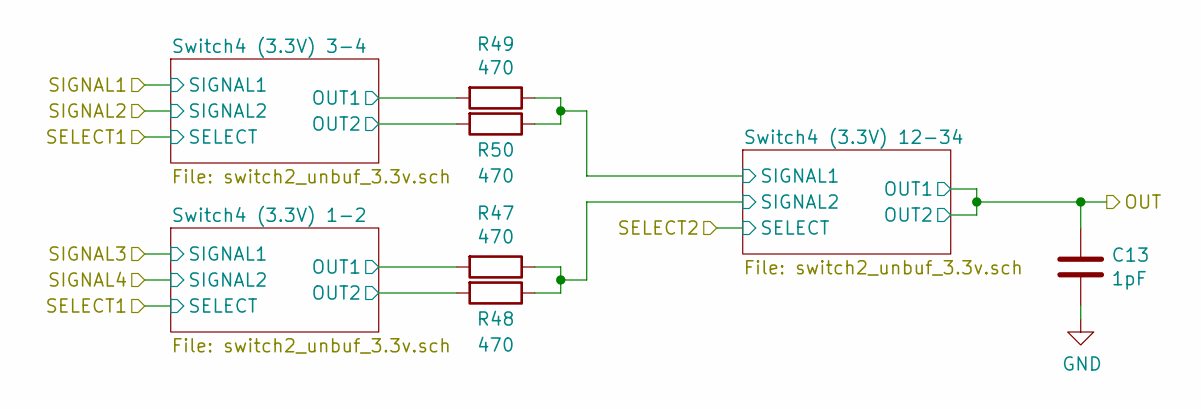
[picture p7: schematic switch4_3.3v.sch]

Parts:
C13: 1pF; C_0603_1608Metric_Pad1.08x0.95mm_HandSolder
R47, R48, R49, R50: 470; R_0603_1608Metric_Pad1.05x0.95mm_HandSolder

Connections:
/Switch4 (3.3V)/OUT: C13.1; also elsewhere on the board
/Switch4 (3.3V)/Switch4 (3.3V) 1-2/OUT1: R47.2; also elsewhere on the board
/Switch4 (3.3V)/Switch4 (3.3V) 1-2/OUT2: R48.2; also elsewhere on the board
/Switch4 (3.3V)/Switch4 (3.3V) 3-4/OUT1: R49.2; also elsewhere on the board
/Switch4 (3.3V)/Switch4 (3.3V) 3-4/OUT2: R50.2; also elsewhere on the board
/Switch4 (3.3V)/Switch4 (3.3V) 12-34/SIGNAL1: R49.1, R50.1; also elsewhere on the board
/Switch4 (3.3V)/Switch4 (3.3V) 12-34/SIGNAL2: R47.1, R48.1; also elsewhere on the board
GND: C13.2; also elsewhere on the board

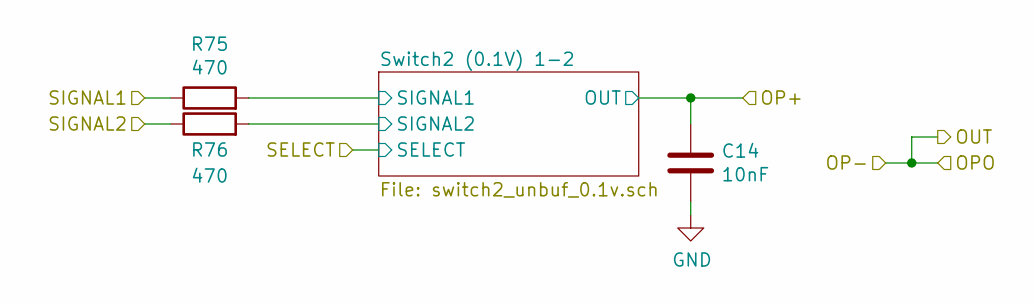
[picture p8: schematic switch2_0.1v.sch]

Parts:
C14: 10nF; C_0603_1608Metric_Pad1.08x0.95mm_HandSolder
R75, R76: 470; R_0603_1608Metric_Pad1.05x0.95mm_HandSolder

Connections:
/Ring Modulator/SIGNAL1: R75.1; also elsewhere on the board
/Switch2 (0.1V)/OP+: C14.1; also elsewhere on the board
/Switch2 (0.1V)/SIGNAL2: R76.1; also elsewhere on the board
/Switch2 (0.1V)/Switch2 (0.1V) 1-2/SIGNAL1: R75.2; also elsewhere on the board
/Switch2 (0.1V)/Switch2 (0.1V) 1-2/SIGNAL2: R76.2; also elsewhere on the board
GND: C14.2; also elsewhere on the board

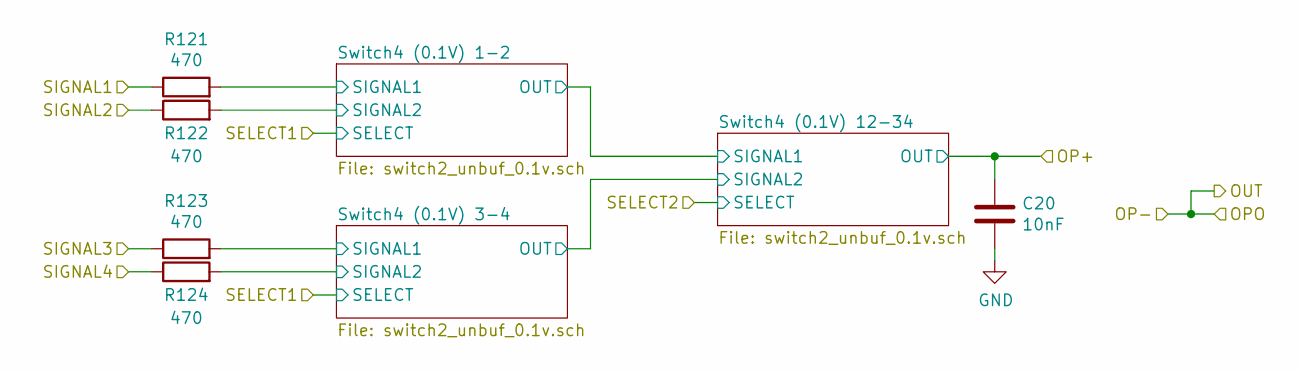
[picture p9: schematic switch4_0.1v.sch]

Parts:
C20: 10nF; C_0603_1608Metric_Pad1.08x0.95mm_HandSolder
R121, R122, R123, R124: 470; R_0603_1608Metric_Pad1.05x0.95mm_HandSolder

Connections:
/Filter/SIGNAL: R121.1; also elsewhere on the board
/Switch4 (0.1V)/OP+: C20.1; also elsewhere on the board
/Switch4 (0.1V)/SIGNAL2: R122.1; also elsewhere on the board
/Switch4 (0.1V)/SIGNAL3: R123.1; also elsewhere on the board
/Switch4 (0.1V)/SIGNAL4: R124.1; also elsewhere on the board
/Switch4 (0.1V)/Switch4 (0.1V) 1-2/SIGNAL1: R121.2; also elsewhere on the board
/Switch4 (0.1V)/Switch4 (0.1V) 1-2/SIGNAL2: R122.2; also elsewhere on the board
/Switch4 (0.1V)/Switch4 (0.1V) 3-4/SIGNAL1: R123.2; also elsewhere on the board
/Switch4 (0.1V)/Switch4 (0.1V) 3-4/SIGNAL2: R124.2; also elsewhere on the board
GND: C20.2; also elsewhere on the board

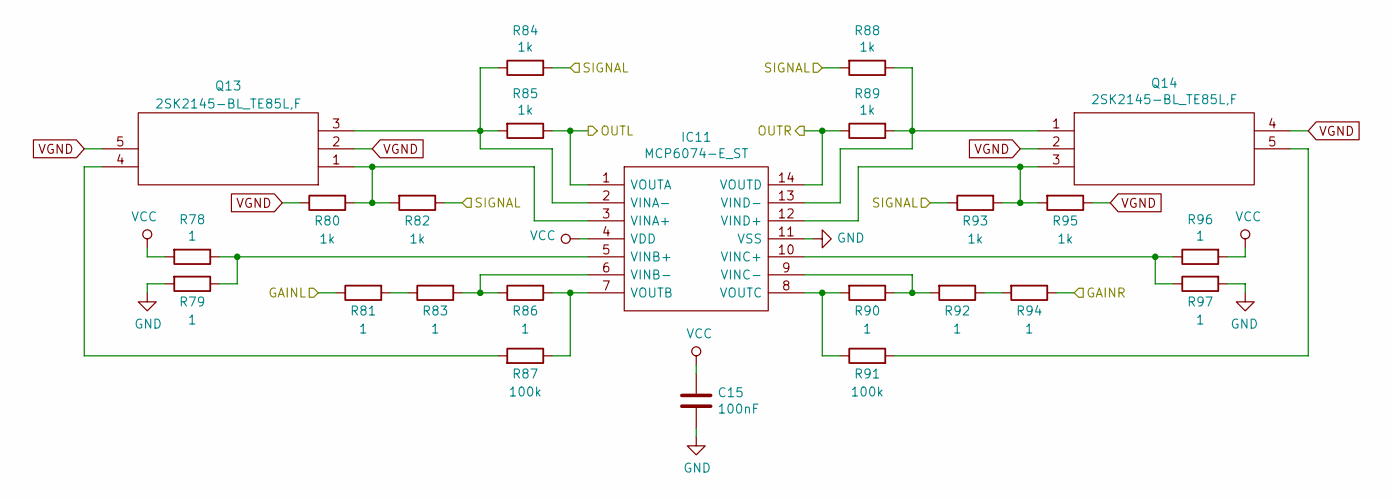
[picture p10: schematic attenuators.sch]

Parts:
C15: 100nF; C_0603_1608Metric_Pad1.08x0.95mm_HandSolder
IC11: MCP6074-E_ST; SOP65P640X120-14N; Manufacturer_Part_Number MCP6074-E/ST; Mouser Part Number 579-MCP6074-E/ST
Q13, Q14: 2SK2145-BL_TE85L,F; SOT95P275X130-5N; Manufacturer_Part_Number 2SK2145-BL(TE85L,F; Mouser Part Number 757-2SK2145BLTE85LF
R78, R79, R81, R83, R86, R90, R92, R94, R96, R97: 1; R_0603_1608Metric_Pad1.05x0.95mm_HandSolder
R80, R82, R84, R85, R88, R89, R93, R95: 1k; R_0603_1608Metric_Pad1.05x0.95mm_HandSolder
R87, R91: 100k; R_0603_1608Metric_Pad1.05x0.95mm_HandSolder

Connections:
/Attenuators/GAINL: R81.1; also elsewhere on the board
/Attenuators/GAINR: R94.1; also elsewhere on the board
/Attenuators/SIGNAL: R82.1, R84.2, R88.2, R93.1; also elsewhere on the board
GND: C15.2, IC11.11 (VSS), R79.2, R97.2; also elsewhere on the board
LEFT: IC11.1 (VOUTA), R85.1; also elsewhere on the board
unnamed: IC11.2 (VINA-), Q13.3, R84.1, R85.2
unnamed: IC11.3 (VINA+), Q13.1, R80.2, R82.2
unnamed: IC11.5 (VINB+), R78.1, R79.1
unnamed: IC11.6 (VINB-), R83.2, R86.1
unnamed: IC11.7 (VOUTB), R86.2, R87.1
unnamed: IC11.8 (VOUTC), R90.2, R91.1
unnamed: IC11.9 (VINC-), R90.1, R92.2
unnamed: IC11.10 (VINC+), R96.1, R97.1
unnamed: IC11.12 (VIND+), Q14.3, R93.2, R95.2
unnamed: IC11.13 (VIND-), Q14.1, R88.1, R89.2
unnamed: Q13.4, R87.2
unnamed: Q14.5, R91.2
unnamed: R81.2, R83.1
unnamed: R92.1, R94.2
RIGHT: IC11.14 (VOUTD), R89.1; also elsewhere on the board
VCC: C15.1, IC11.4 (VDD), R78.2, R96.2; also elsewhere on the board
VGND: Q13.2, Q13.5, Q14.2, Q14.4, R80.1, R95.1; also elsewhere on the board
