amigageek/susy/pcb/channel/channel.kicad_pcb

## KiCad design pcb/channel/channel.kicad_pcb (continued)

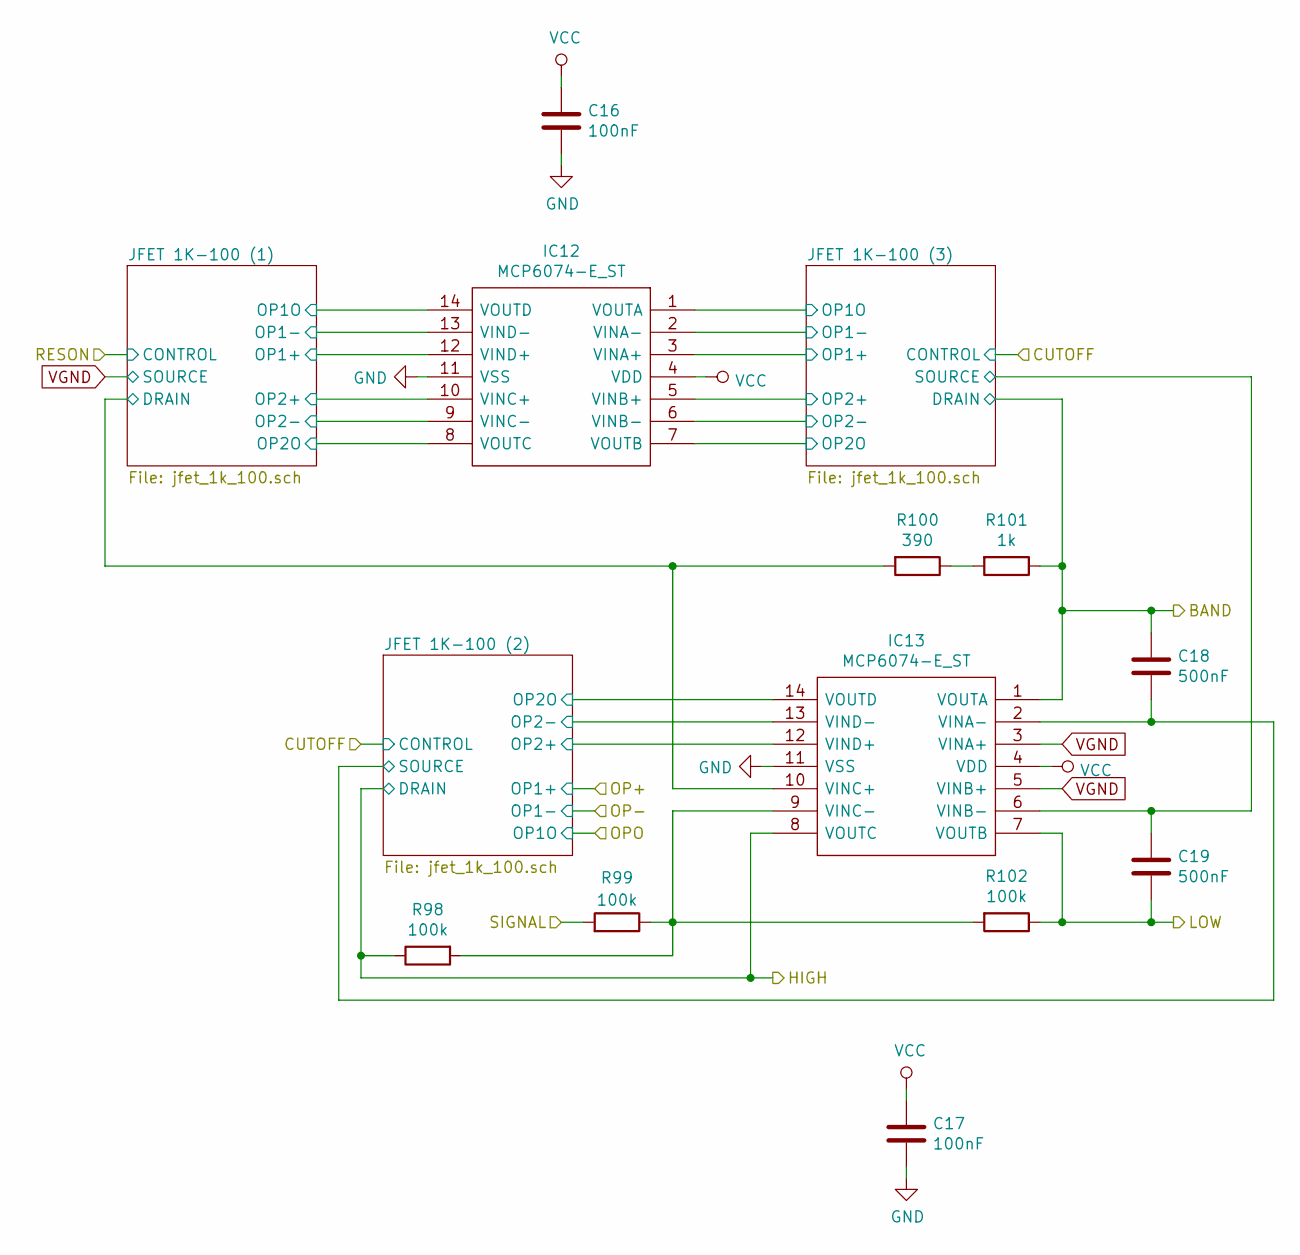
[picture p11: schematic filter.sch]

Parts:
C16, C17: 100nF; C_0603_1608Metric_Pad1.08x0.95mm_HandSolder
C18, C19: 500nF; C_0603_1608Metric_Pad1.08x0.95mm_HandSolder
IC12, IC13: MCP6074-E_ST; SOP65P640X120-14N; Manufacturer_Part_Number MCP6074-E/ST; Mouser Part Number 579-MCP6074-E/ST
R98, R99, R102: 100k; R_0603_1608Metric_Pad1.05x0.95mm_HandSolder
R100: 390; R_0603_1608Metric_Pad1.05x0.95mm_HandSolder
R101: 1k; R_0603_1608Metric_Pad1.05x0.95mm_HandSolder

Connections:
/Filter/BAND: C18.1, IC12.5 (VINB+), IC13.1 (VOUTA), R101.1; also elsewhere on the board
/Filter/HIGH: IC13.8 (VOUTC), IC13.12 (VIND+), R98.1; also elsewhere on the board
/Filter/JFET 1K-100 (1)/DRAIN: IC12.10 (VINC+), IC13.10 (VINC+), R100.2; also elsewhere on the board
/Filter/JFET 1K-100 (1)/OP1+: IC12.12 (VIND+); also elsewhere on the board
/Filter/JFET 1K-100 (1)/OP1-: IC12.13 (VIND-); also elsewhere on the board
/Filter/JFET 1K-100 (1)/OP1O: IC12.14 (VOUTD); also elsewhere on the board
/Filter/JFET 1K-100 (1)/OP2-: IC12.8 (VOUTC), IC12.9 (VINC-); also elsewhere on the board
/Filter/JFET 1K-100 (2)/OP2-: IC13.13 (VIND-), IC13.14 (VOUTD); also elsewhere on the board
/Filter/JFET 1K-100 (2)/SOURCE: C18.2, IC13.2 (VINA-); also elsewhere on the board
/Filter/JFET 1K-100 (3)/OP1+: IC12.3 (VINA+); also elsewhere on the board
/Filter/JFET 1K-100 (3)/OP1-: IC12.2 (VINA-); also elsewhere on the board
/Filter/JFET 1K-100 (3)/OP1O: IC12.1 (VOUTA); also elsewhere on the board
/Filter/JFET 1K-100 (3)/OP2-: IC12.6 (VINB-), IC12.7 (VOUTB); also elsewhere on the board
/Filter/JFET 1K-100 (3)/SOURCE: C19.1, IC13.6 (VINB-); also elsewhere on the board
/Filter/LOW: C19.2, IC13.7 (VOUTB), R102.1; also elsewhere on the board
/Filter/SIGNAL: R99.2; also elsewhere on the board
GND: C16.2, C17.2, IC12.11 (VSS), IC13.11 (VSS); also elsewhere on the board
unnamed: IC13.9 (VINC-), R98.2, R99.1, R102.2
unnamed: R100.1, R101.2
VCC: C16.1, C17.1, IC12.4 (VDD), IC13.4 (VDD); also elsewhere on the board
VGND: IC13.3 (VINA+), IC13.5 (VINB+); also elsewhere on the board

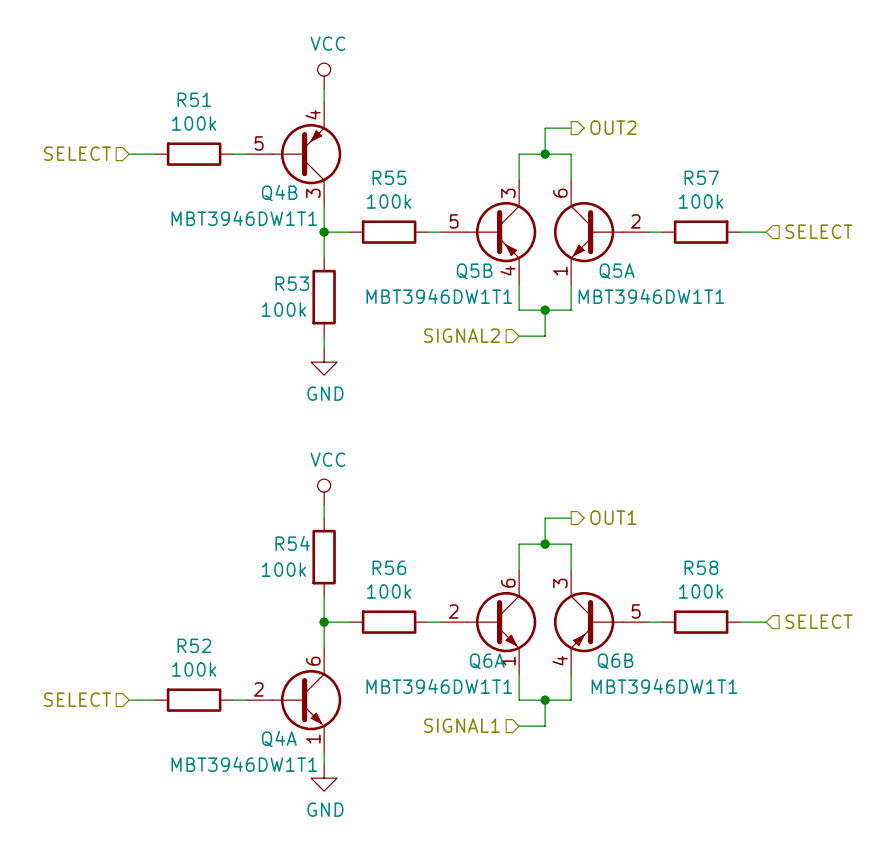
[picture p12: schematic switch2_unbuf_3.3v.sch]

Parts:
Q4, Q5, Q6: MBT3946DW1T1; SOT-363_SC-70-6
R51, R52, R53, R54, R55, R56, R57, R58: 100k; R_0603_1608Metric_Pad1.05x0.95mm_HandSolder

Connections:
/Switch4 (3.3V)/OUT: Q5.3 (C2), Q5.6 (C1), Q6.3 (C2), Q6.6 (C1); also elsewhere on the board
/Switch4 (3.3V)/Switch4 (3.3V) 12-34/SIGNAL1: Q6.1 (E1), Q6.4 (E2); also elsewhere on the board
/Switch4 (3.3V)/Switch4 (3.3V) 12-34/SIGNAL2: Q5.1 (E1), Q5.4 (E2); also elsewhere on the board
GND: Q4.1 (E1), R53.2; also elsewhere on the board
unnamed: Q4.2 (B1), R52.1
unnamed: Q4.3 (C2), R53.1, R55.2
unnamed: Q4.5 (B2), R51.1
unnamed: Q4.6 (C1), R54.2, R56.2
unnamed: Q5.2 (B1), R57.1
unnamed: Q5.5 (B2), R55.1
unnamed: Q6.2 (B1), R56.1
unnamed: Q6.5 (B2), R58.1
OSELB: R51.2, R52.2, R57.2, R58.2; also elsewhere on the board
VCC: Q4.4 (E2), R54.1; also elsewhere on the board

Parts of its further copies:
Q7, Q8, Q9, Q10, Q11, Q12: MBT3946DW1T1; SOT-363_SC-70-6
R59, R60, R61, R62, R63, R64, R65, R66, R67, R68, R69, R70, R71, R72, R73, R74: 100k; R_0603_1608Metric_Pad1.05x0.95mm_HandSolder

Connections of its further copies:
/Switch4 (3.3V)/SIGNAL1: Q9.1 (E1), Q9.4 (E2); also elsewhere on the board
/Switch4 (3.3V)/SIGNAL2: Q8.1 (E1), Q8.4 (E2); also elsewhere on the board
/Switch4 (3.3V)/SIGNAL3: Q12.1 (E1), Q12.4 (E2); also elsewhere on the board
/Switch4 (3.3V)/SIGNAL4: Q11.1 (E1), Q11.4 (E2); also elsewhere on the board
/Switch4 (3.3V)/Switch4 (3.3V) 1-2/OUT1: Q12.3 (C2), Q12.6 (C1); also elsewhere on the board
/Switch4 (3.3V)/Switch4 (3.3V) 1-2/OUT2: Q11.3 (C2), Q11.6 (C1); also elsewhere on the board
/Switch4 (3.3V)/Switch4 (3.3V) 3-4/OUT1: Q9.3 (C2), Q9.6 (C1); also elsewhere on the board
/Switch4 (3.3V)/Switch4 (3.3V) 3-4/OUT2: Q8.3 (C2), Q8.6 (C1); also elsewhere on the board
GND: Q7.1 (E1), Q10.1 (E1), R61.2, R69.2; also elsewhere on the board
unnamed: Q7.2 (B1), R60.1
unnamed: Q7.3 (C2), R61.1, R63.2
unnamed: Q7.5 (B2), R59.1
unnamed: Q7.6 (C1), R62.2, R64.2
unnamed: Q8.2 (B1), R65.1
unnamed: Q8.5 (B2), R63.1
unnamed: Q9.2 (B1), R64.1
unnamed: Q9.5 (B2), R66.1
unnamed: Q10.2 (B1), R68.1
unnamed: Q10.3 (C2), R69.1, R71.2
unnamed: Q10.5 (B2), R67.1
unnamed: Q10.6 (C1), R70.2, R72.2
unnamed: Q11.2 (B1), R73.1
unnamed: Q11.5 (B2), R71.1
unnamed: Q12.2 (B1), R72.1
unnamed: Q12.5 (B2), R74.1
OSELA: R59.2, R60.2, R65.2, R66.2, R67.2, R68.2, R73.2, R74.2; also elsewhere on the board
VCC: Q7.4 (E2), Q10.4 (E2), R62.1, R70.1; also elsewhere on the board

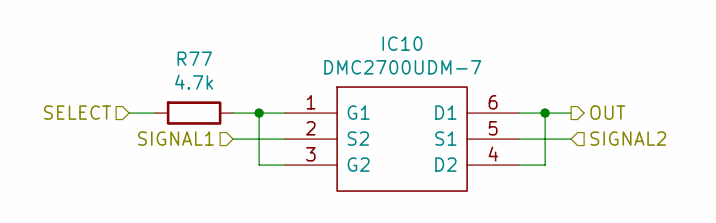
[picture p13: schematic switch2_unbuf_0.1v.sch]

Parts:
IC14: DMC2700UDM-7; SOT95P285X140-6N; Manufacturer_Part_Number DMC2700UDM-7; Mouser Part Number 621-DMC2700UDM-7
R125: 4.7k; R_0603_1608Metric_Pad1.05x0.95mm_HandSolder

Connections:
/Switch4 (0.1V)/Switch4 (0.1V) 1-2/OUT: IC14.4 (D2), IC14.6 (D1); also elsewhere on the board
/Switch4 (0.1V)/Switch4 (0.1V) 1-2/SIGNAL1: IC14.2 (S2); also elsewhere on the board
/Switch4 (0.1V)/Switch4 (0.1V) 1-2/SIGNAL2: IC14.5 (S1); also elsewhere on the board
FSELA: R125.2; also elsewhere on the board
unnamed: IC14.1 (G1), IC14.3 (G2), R125.1

Parts of its further copies:
IC10, IC15, IC16: DMC2700UDM-7; SOT95P285X140-6N; Manufacturer_Part_Number DMC2700UDM-7; Mouser Part Number 621-DMC2700UDM-7
R77, R126, R127: 4.7k; R_0603_1608Metric_Pad1.05x0.95mm_HandSolder

Connections of its further copies:
/Switch2 (0.1V)/OP+: IC10.4 (D2), IC10.6 (D1); also elsewhere on the board
/Switch2 (0.1V)/Switch2 (0.1V) 1-2/SIGNAL1: IC10.2 (S2); also elsewhere on the board
/Switch2 (0.1V)/Switch2 (0.1V) 1-2/SIGNAL2: IC10.5 (S1); also elsewhere on the board
/Switch4 (0.1V)/OP+: IC16.4 (D2), IC16.6 (D1); also elsewhere on the board
/Switch4 (0.1V)/Switch4 (0.1V) 1-2/OUT: IC16.2 (S2); also elsewhere on the board
/Switch4 (0.1V)/Switch4 (0.1V) 3-4/OUT: IC15.4 (D2), IC15.6 (D1), IC16.5 (S1)
/Switch4 (0.1V)/Switch4 (0.1V) 3-4/SIGNAL1: IC15.2 (S2); also elsewhere on the board
/Switch4 (0.1V)/Switch4 (0.1V) 3-4/SIGNAL2: IC15.5 (S1); also elsewhere on the board
FSELA: R126.2; also elsewhere on the board
FSELB: R127.2; also elsewhere on the board
unnamed: IC10.1 (G1), IC10.3 (G2), R77.1
unnamed: IC15.1 (G1), IC15.3 (G2), R126.1
unnamed: IC16.1 (G1), IC16.3 (G2), R127.1
RMSEL: R77.2; also elsewhere on the board

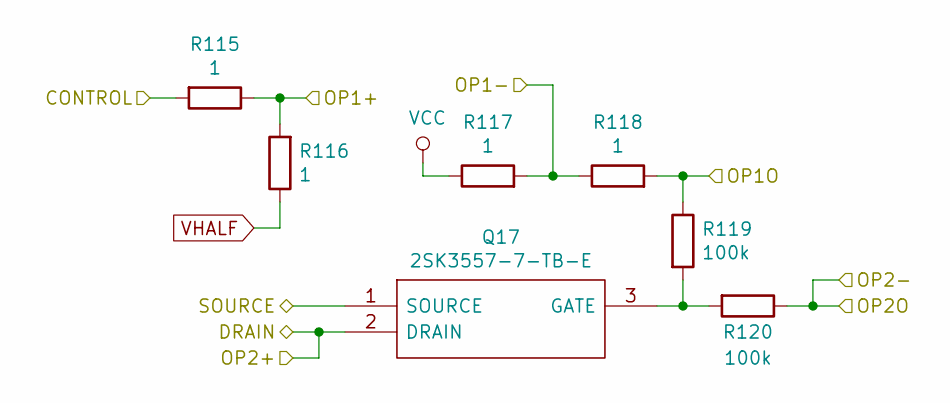
[picture p14: schematic jfet_1k_100.sch]

Parts:
Q15: 2SK3557-7-TB-E; SOT95P250X135-3N; Manufacturer_Part_Number 2SK3557-7-TB-E; Mouser Part Number 863-2SK3557-7-TB-E
R103, R104, R105, R106: 1; R_0603_1608Metric_Pad1.05x0.95mm_HandSolder
R107, R108: 100k; R_0603_1608Metric_Pad1.05x0.95mm_HandSolder

Connections:
/Filter/JFET 1K-100 (1)/DRAIN: Q15.2 (DRAIN); also elsewhere on the board
/Filter/JFET 1K-100 (1)/OP1+: R103.1, R104.2; also elsewhere on the board
/Filter/JFET 1K-100 (1)/OP1-: R105.2, R106.1; also elsewhere on the board
/Filter/JFET 1K-100 (1)/OP1O: R106.2, R107.1; also elsewhere on the board
/Filter/JFET 1K-100 (1)/OP2-: R108.1; also elsewhere on the board
/Filter/RESON: R103.2; also elsewhere on the board
unnamed: Q15.3 (GATE), R107.2, R108.2
VCC: R105.1; also elsewhere on the board
VGND: Q15.1 (SOURCE); also elsewhere on the board
VHALF: R104.1; also elsewhere on the board

Parts of its further copies:
Q16, Q17: 2SK3557-7-TB-E; SOT95P250X135-3N; Manufacturer_Part_Number 2SK3557-7-TB-E; Mouser Part Number 863-2SK3557-7-TB-E
R109, R110, R111, R112, R115, R116, R117, R118: 1; R_0603_1608Metric_Pad1.05x0.95mm_HandSolder
R113, R114, R119, R120: 100k; R_0603_1608Metric_Pad1.05x0.95mm_HandSolder

Connections of its further copies:
/Filter/BAND: Q16.2 (DRAIN); also elsewhere on the board
/Filter/CUTOFF: R109.2, R115.2; also elsewhere on the board
/Filter/HIGH: Q17.2 (DRAIN); also elsewhere on the board
/Filter/JFET 1K-100 (2)/OP2-: R120.1; also elsewhere on the board
/Filter/JFET 1K-100 (2)/SOURCE: Q17.1 (SOURCE); also elsewhere on the board
/Filter/JFET 1K-100 (3)/OP1+: R109.1, R110.2; also elsewhere on the board
/Filter/JFET 1K-100 (3)/OP1-: R111.2, R112.1; also elsewhere on the board
/Filter/JFET 1K-100 (3)/OP1O: R112.2, R113.1; also elsewhere on the board
/Filter/JFET 1K-100 (3)/OP2-: R114.1; also elsewhere on the board
/Filter/JFET 1K-100 (3)/SOURCE: Q16.1 (SOURCE); also elsewhere on the board
/Filter/OP+: R115.1, R116.2; also elsewhere on the board
/Filter/OP-: R117.2, R118.1; also elsewhere on the board
/Filter/OPO: R118.2, R119.1; also elsewhere on the board
unnamed: Q16.3 (GATE), R113.2, R114.2
unnamed: Q17.3 (GATE), R119.2, R120.2
VCC: R111.1, R117.1; also elsewhere on the board
VHALF: R110.1, R116.1; also elsewhere on the board

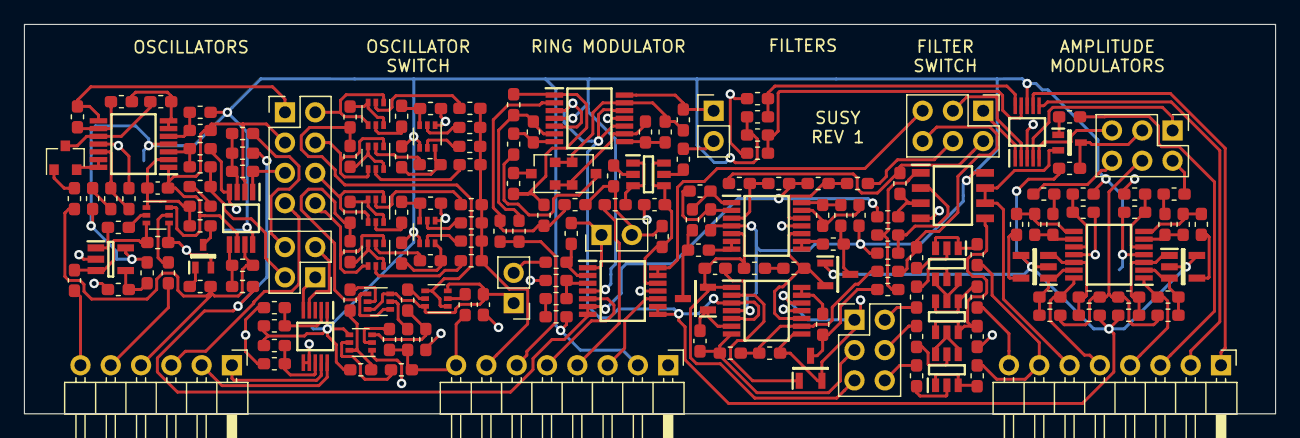
[picture p15: board channel.kicad_pcb from above]

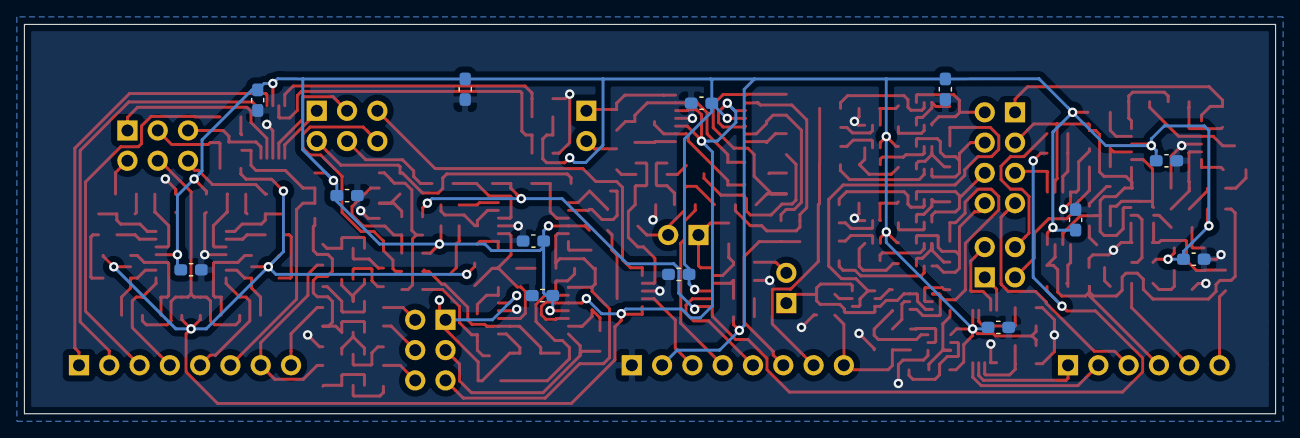
[picture p16: board channel.kicad_pcb from below]

Board: 2 copper layers, 104.9 x 32.6 mm, 199 parts (13 on the bottom side), 174 nets.
