amigageek/susy/(commit log)

2021-03-16 Add channel PCB revision 1
    [attenuators.sch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]
2021-03-17 Replace component cache with symbol/footprint source
2021-03-17 Match simulation components to PCB, tweak top-level simulations
2021-05-17 Fix attenuator JFET calibration math
2021-05-17 Reduce JFET base resistor from 1Meg to 100K
    Precaution against too much voltage drop to base
    [jfet_1k_100.sch]
2021-05-17 Set final resistor values for oscillator
    [oscillator.sch]
2021-05-17 Increase ring modulator gain for 100mVpp output
    [ring_modulator.sch]
2021-05-17 Substitute available resistor values
    [shift_scale.sch]
2021-05-17 Rename/renumbering (I think)
    [channel.kicad_pcb, switch2_unbuf_0.1v.sch, switch2_unbuf_3.3v.sch]
2022-05-02 Add interface PCB files
    [connectors.kicad_sch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]
